Samuele68/airsense/calibration data/round2/data/20180110_112239.jpg

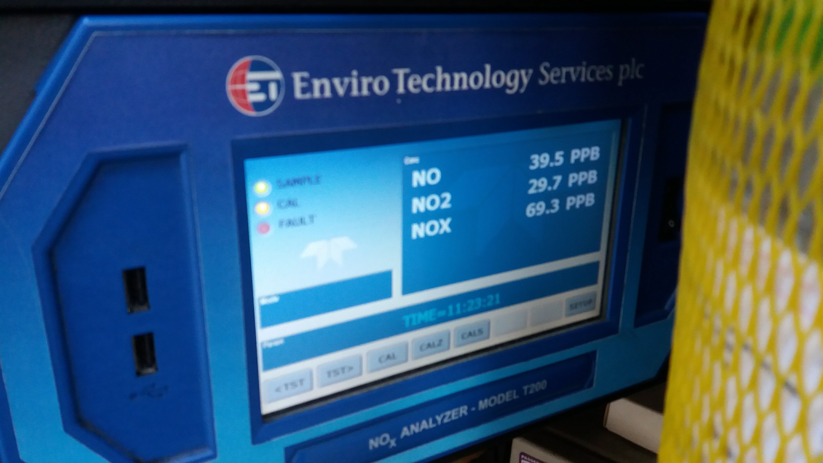
calibration data/round2/data/20180110_112239.jpg
