Samuele68/airsense/calibration data/round2/data/20180118_114009.jpg

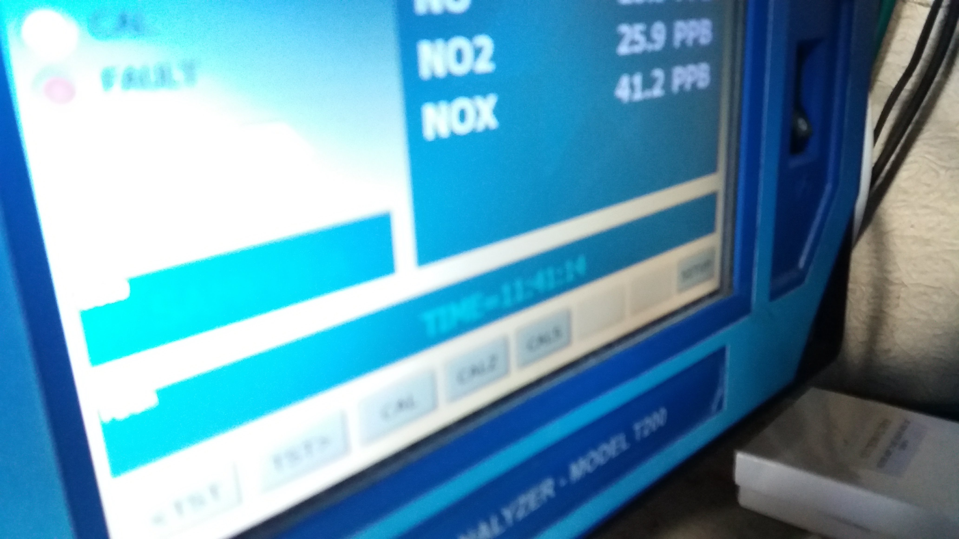
calibration data/round2/data/20180118_114009.jpg
