Samuele68/airsense/README.md

# airsense
a DIY affordable air quality sensor
