Samuele68/airsense/calibration data/round2/data/README.md

Files:

airsense.csv: data collected by the DIY sensor
reference.csv: data collected by official monitor

- Started: 10/01/2018
11:22:39 at mobile phone
11:23:21 at reference
0 at sensor

- Stopped: 18/01/2018
11:40:09 at mobile phone
11:41:14 at reference
691672514 at sensor
