Samuele68/airsense/calibration data/round2/analysis/README.md

#Aanalysis of the calibration data, round 2

This code is written in JavaScript and runs with nodejs.

    npm install

To install dependencies. Then

    node analysis.js

To see the results.
