Samuele68/airsense/calibration data/round1/data/AIRSENSE.CSV

timestamp humidity temperature rawNO2_Mics rawNO2_SPEC rawNO2_Alpha1 rawNO2_Alpha2 rawmq2 dustratio
38643 55 25 931 274 17 6 64 0.00
98813 50 20 898 286 32 29 48 2.64
158978 -1 -1 872 288 36 36 45 69.68
219210 -1 -1 847 323 40 37 43 44.17
279454 -1 -1 810 303 45 40 46 12.78
339641 -1 -1 795 251 46 41 42 14.88
400094 -1 -1 770 307 48 41 45 12.40
460236 -1 -1 755 295 43 41 41 31.61
520308 0 0 744 291 48 41 41 38.89
580462 -1 -1 726 279 47 43 42 46.10
640559 -1 -1 725 286 49 43 42 55.27
700670 -1 -1 700 286 49 42 43 57.77
760838 -1 -1 688 275 49 40 41 56.56
820937 -1 -1 677 287 45 43 42 53.26
880989 47 24 670 281 51 44 39 53.76
941247 -1 -1 664 287 48 44 42 52.18
1001400 65 12 651 283 48 44 42 52.80
1061526 65 18 641 289 51 44 41 54.16
1121681 50 18 626 292 48 43 42 44.86
1181840 65 18 621 293 48 44 40 58.12
1241952 57 12 608 286 49 44 42 57.38
1302078 70 17 604 284 47 44 41 57.48
1362330 65 17 596 291 47 44 41 28.29
1422425 65 17 593 279 49 45 41 37.10
1482683 64 17 586 292 47 44 42 0.87
1542857 60 17 582 291 48 45 42 0.72
1602985 58 17 571 284 49 44 41 0.26
1663688 58 17 560 292 48 45 41 0.08
1724136 61 17 549 284 48 45 41 0.69
1784774 60 17 538 284 49 45 41 0.37
1844978 59 17 536 292 48 45 42 0.21
1905159 60 17 528 285 48 45 41 0.39
1965687 56 17 511 285 49 45 41 0.11
2025853 59 17 504 292 48 45 41 0.19
2086025 59 17 492 283 49 45 41 0.10
2146323 57 17 486 290 48 45 41 0.71
2206803 55 17 480 285 49 45 41 0.00
2267282 59 17 484 285 48 45 40 0.00
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
194354348 82 14 52 273 53 46 43 0.17
194414638 78 19 73 258 48 47 43 0.00
194475024 81 16 50 310 48 45 43 0.04
194535638 81 15 70 303 48 49 43 0.04
194596122 81 16 55 281 48 46 44 0.03
194656822 82 14 65 318 48 45 44 0.39
194717082 82 15 58 263 48 45 43 0.00
194777345 82 15 88 317 50 46 43 0.04
194837825 83 17 76 311 48 45 42 0.00
194898305 82 13 58 305 54 46 43 0.00
194958654 82 16 62 293 49 48 43 0.19
195019308 83 14 64 322 51 46 44 0.20
195079540 83 17 85 301 50 47 43 0.01
195139668 82 16 66 279 51 46 45 0.03
195200140 83 18 66 276 49 47 44 0.13
195260314 78 19 88 279 51 47 43 0.06
195320958 78 19 43 279 48 46 42 0.19
195381368 77 21 52 291 50 47 43 1.15
195441932 81 17 92 298 48 49 43 0.44
195502137 79 17 128 283 52 46 43 0.01
195562339 80 17 99 280 52 46 44 0.39
195622715 79 17 131 313 52 46 43 0.50
195683148 82 17 160 282 49 46 43 0.04
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
