Samuele68/airsense/calibration data/round1/data/reference.csv

TimeStamp | NO2CNC1-AVG(PPB) | NOXCNC1-AVG(PPB) | NOCNC1-AVG(PPB)
05/18/2017 10:41:02 | 0.0 | 33.4 | 33.4
05/18/2017 10:42:01 | 16.8 | 35.3 | 18.4
05/18/2017 10:43:01 | 18.6 | 27.6 | 8.9
05/18/2017 10:44:01 | 17.0 | 26.2 | 9.2
05/18/2017 10:45:01 | 29.5 | 51.6 | 22.1
05/18/2017 10:46:01 | 12.5 | 28.4 | 15.8
05/18/2017 10:47:01 | 24.7 | 66.7 | 42.0
05/18/2017 10:48:01 | 17.7 | 50.4 | 32.7
05/18/2017 10:49:01 | 19.7 | 39.5 | 19.7
05/18/2017 10:50:01 | 12.0 | 66.1 | 54.1
05/18/2017 10:51:01 | 10.8 | 23.1 | 12.3
05/18/2017 10:52:01 | 9.1 | 19.4 | 10.3
05/18/2017 10:53:01 | 9.5 | 22.7 | 13.2
05/18/2017 10:54:01 | 57.7 | 124.5 | 66.8
05/18/2017 10:55:01 | 22.6 | 71.1 | 48.5
05/18/2017 10:56:01 | 11.9 | 25.8 | 13.9
05/18/2017 10:57:01 | 25.2 | 85.1 | 59.9
05/18/2017 10:58:01 | 19.5 | 46.3 | 26.8
05/18/2017 10:59:01 | 3.8 | 12.7 | 8.8
05/18/2017 11:00:01 | 18.4 | 30.1 | 11.7
05/18/2017 11:01:01 | 17.2 | 29.6 | 12.4
05/18/2017 11:02:01 | 18.5 | 65.9 | 47.4
05/18/2017 11:03:01 | 18.5 | 26.8 | 8.3
05/18/2017 11:04:01 | 25.0 | 67.6 | 42.6
05/18/2017 11:05:01 | 110.0 | 197.0 | 87.0
05/18/2017 11:06:01 | 9.9 | 16.5 | 6.6
05/18/2017 11:07:01 | 9.1 | 19.3 | 10.2
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
