Samuele68/airsense/calibration data/round2/data/AIRSENSE.CSV

timestamp | temperature | humidity | pressure | custom_MICS | ratio_NH3 | ratio_CO | ratio_NO2 | nh3 | co | no2 | c3h8 | c4h10 | ch4 | h2 | c2h5oh | alpha1 | alpha2 | alphadiff | specdiff
7379 | 10 | 75 | 99904.00 | 938 | 1.0000 | 1.0000 | 1.0000 | -1.0000 | -1.0000 | -1.0000 | -1.0000 | -1.0000 | -1.0000 | -1.0000 | -1.0000 | 3475685 | 478187 | 617219 | -143510
67384 | 10 | 77 | 99908.00 | 903 | 1.0000 | 1.0000 | 1.0000 | -1.0000 | -1.0000 | -1.0000 | -1.0000 | -1.0000 | -1.0000 | -1.0000 | -1.0000 | 340904 | 631479 | 420449 | 208140
127384 | 10 | 77 | 99918.00 | 885 | 1.0000 | 1.0000 | 1.0000 | -1.0000 | -1.0000 | -1.0000 | -1.0000 | -1.0000 | -1.0000 | -1.0000 | -1.0000 | 191822 | 627501 | 402771 | 224223
187394 | 9 | 77 | 99914.00 | 871 | 1.0000 | 1.0000 | 1.0000 | -1.0000 | -1.0000 | -1.0000 | -1.0000 | -1.0000 | -1.0000 | -1.0000 | -1.0000 | 236047 | 626122 | 396668 | 224490
247397 | 10 | 77 | 99913.00 | 861 | 1.0000 | 1.0000 | 1.0000 | -1.0000 | -1.0000 | -1.0000 | -1.0000 | -1.0000 | -1.0000 | -1.0000 | -1.0000 | 1361908 | 620748 | 394507 | 224027
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
