Samuele68/airsense/calibration data/round2/data/reference.csv

Date | Time | NO2CNC1 | NOXCNC1 | NOCNC1
2018/01/12 | 00:44 | 25.3 | 66.8 | 41.5
2018/01/12 | 00:45 | 0.0 | 0.0 | 0.0
2018/01/12 | 00:46 | 0.0 | 0.0 | 0.0
2018/01/12 | 00:47 | 0.0 | 0.0 | 0.0
2018/01/12 | 00:48 | 0.0 | 0.0 | 0.0
2018/01/12 | 00:49 | 0.0 | 0.0 | 0.0
2018/01/12 | 00:50 | 0.0 | 0.0 | 0.0
2018/01/12 | 00:51 | 0.0 | 0.0 | 0.0
2018/01/12 | 00:52 | 0.0 | 0.0 | 0.0
2018/01/12 | 00:53 | 0.0 | 0.0 | 0.0
2018/01/12 | 00:54 | 0.0 | 0.0 | 0.0
2018/01/12 | 00:55 | 0.0 | 0.0 | 0.0
2018/01/12 | 00:56 | 0.0 | 0.0 | 0.0
2018/01/12 | 00:57 | 0.0 | 0.0 | 0.0
2018/01/12 | 00:58 | 0.0 | 0.0 | 0.0
2018/01/12 | 00:59 | 0.0 | 0.0 | 0.0
2018/01/12 | 01:00 | 0.0 | 0.0 | 0.0
2018/01/12 | 01:01 | 0.0 | 0.0 | 0.0
2018/01/12 | 01:02 | 0.0 | 0.0 | 0.0
2018/01/12 | 01:03 | 0.0 | 0.0 | 0.0
2018/01/12 | 01:04 | 0.0 | 0.0 | 0.0
2018/01/12 | 01:05 | 0.0 | 0.0 | 0.0
2018/01/12 | 01:06 | 0.0 | 0.0 | 0.0
2018/01/12 | 01:07 | 0.0 | 0.0 | 0.0
2018/01/12 | 01:08 | 0.0 | 0.0 | 0.0
2018/01/12 | 01:09 | 0.0 | 0.0 | 0.0
2018/01/12 | 01:10 | 0.0 | 0.0 | 0.0
2018/01/12 | 01:11 | 0.0 | 0.0 | 0.0
2018/01/12 | 01:12 | 0.0 | 0.0 | 0.0
2018/01/12 | 01:13 | 0.0 | 0.0 | 0.0
2018/01/12 | 01:14 | 0.0 | 0.0 | 0.0
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
