Samuele68/airsense/calibration data/round3/data/Log-20190118-102419.log.csv

Date | Time | NO2CNC1 | NOXCNC1 | NOCNC1
2019/1/4 | 13:29 | 23.6 | 38.9 | 15.3
2019/1/4 | 13:30 | 12.8 | 29.2 | 16.4
2019/1/4 | 13:31 | 17.8 | 39.8 | 22.0
2019/1/4 | 13:32 | 12.9 | 30.9 | 18.0
2019/1/4 | 13:33 | 13.7 | 34.6 | 20.8
2019/1/4 | 13:34 | 14.6 | 36.3 | 21.7
2019/1/4 | 13:35 | 44.0 | 97.2 | 53.2
2019/1/4 | 13:36 | 6.9 | 14.6 | 7.6
2019/1/4 | 13:37 | 51.0 | 101.4 | 50.4
2019/1/4 | 13:38 | 12.2 | 45.6 | 33.4
2019/1/4 | 13:39 | 48.3 | 117.7 | 69.4
2019/1/4 | 13:40 | 38.7 | 88.5 | 49.8
2019/1/4 | 13:41 | 18.5 | 32.8 | 14.3
2019/1/4 | 13:42 | 10.5 | 20.6 | 10.1
2019/1/4 | 13:43 | 10.6 | 21.2 | 10.7
2019/1/4 | 13:44 | 24.3 | 44.9 | 20.7
2019/1/4 | 13:45 | 23.3 | 59.2 | 35.9
2019/1/4 | 13:46 | 33.7 | 100.0 | 66.3
2019/1/4 | 13:47 | 9.9 | 46.4 | 36.5
2019/1/4 | 13:48 | 19.5 | 38.8 | 19.3
2019/1/4 | 13:49 | 19.8 | 35.0 | 15.2
2019/1/4 | 13:50 | 19.0 | 33.4 | 14.5
2019/1/4 | 13:51 | 2.3 | 41.3 | 39.1
2019/1/4 | 13:52 | 43.0 | 77.9 | 34.9
2019/1/4 | 13:53 | 4.4 | 6.3 | 1.9
2019/1/4 | 13:54 | 30.4 | 151.4 | 121.0
2019/1/4 | 13:55 | 28.5 | 81.4 | 52.9
2019/1/4 | 13:56 | 28.5 | 96.6 | 68.1
2019/1/4 | 13:57 | 23.4 | 123.1 | 99.7
2019/1/4 | 13:58 | 14.0 | 29.7 | 15.7
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
