Samuele68/airsense/calibration data/round3/data/Log-20190122-093909.log.csv

Date | Time | NO2CNC1 | NOXCNC1 | NOCNC1
2019/1/18 | 0:0 | 21.1 | 43.0 | 21.9
2019/1/18 | 0:1 | 14.0 | 34.6 | 20.5
2019/1/18 | 0:2 | 21.7 | 29.9 | 8.2
2019/1/18 | 0:3 | 21.2 | 32.7 | 11.6
2019/1/18 | 0:4 | 21.3 | 36.0 | 14.7
2019/1/18 | 0:5 | 28.0 | 63.4 | 35.4
2019/1/18 | 0:6 | 7.5 | 58.5 | 51.0
2019/1/18 | 0:7 | 27.0 | 94.3 | 67.3
2019/1/18 | 0:8 | 20.4 | 80.3 | 60.0
2019/1/18 | 0:9 | 21.0 | 78.0 | 57.0
2019/1/18 | 0:10 | 21.2 | 76.0 | 54.8
2019/1/18 | 0:11 | 21.7 | 73.5 | 51.8
2019/1/18 | 0:12 | 21.8 | 71.1 | 49.3
2019/1/18 | 0:13 | 22.1 | 68.3 | 46.2
2019/1/18 | 0:14 | 22.4 | 65.5 | 43.1
2019/1/18 | 0:15 | 22.4 | 62.1 | 39.6
2019/1/18 | 0:16 | 20.9 | 98.5 | 77.6
2019/1/18 | 0:17 | 20.4 | 66.4 | 45.9
2019/1/18 | 0:18 | 21.2 | 104.9 | 83.6
2019/1/18 | 0:19 | 24.9 | 61.3 | 36.4
2019/1/18 | 0:20 | 24.5 | 61.1 | 36.6
2019/1/18 | 0:21 | 24.2 | 63.2 | 39.0
2019/1/18 | 0:22 | 24.1 | 64.3 | 40.2
2019/1/18 | 0:23 | 24.1 | 64.0 | 39.9
2019/1/18 | 0:24 | 18.2 | 72.7 | 54.5
2019/1/18 | 0:25 | 24.0 | 56.9 | 32.9
2019/1/18 | 0:26 | 23.4 | 47.9 | 24.5
2019/1/18 | 0:27 | 23.1 | 49.7 | 26.6
2019/1/18 | 0:28 | 23.2 | 51.2 | 28.0
2019/1/18 | 0:29 | 22.3 | 78.8 | 56.6
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
