Samuele68/airsense/calibration data/round3/data/IMG_20190102_134548.jpg

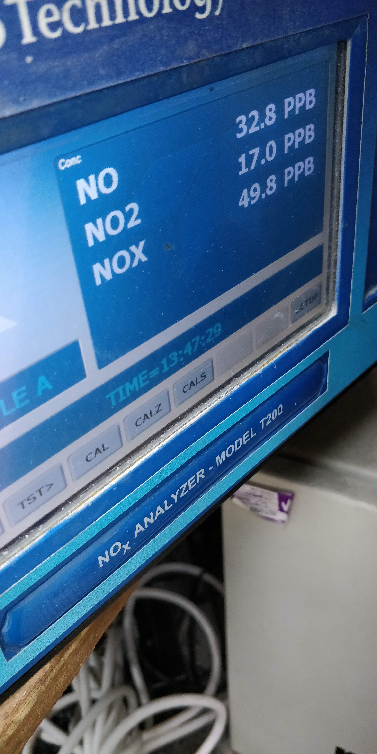
calibration data/round3/data/IMG_20190102_134548.jpg
