Samuele68/airsense/Arduino sketches/testADS1256/testADS1256.ino

#include <Wire.h>
#include <SPI.h>

#define ADS_RST_PIN             4        // ADS1256 reset pin
#define ADS_CS_PIN              5        // ADS1256 chip select
#define ADS_RDY_PIN             6        // ADS1256 data ready

void setup() {
  Serial.begin(9600);

  //start the spi-bus
  SPI.begin();
  initADS();
}

void loop() {
  long alpha0 = readADS(0);
  long alpha1 = readADS(1);
  long alphadiff = readADSDiff(0, 1);
  
  Serial.print(alpha0);
  Serial.print(",");
  Serial.print(alpha1);
  Serial.print(",");
  Serial.print(alphadiff);
  Serial.println();
  
  delay(150);
}
