Samuele68/airsense/(commit log)

2018-06-24 added calibration data, round 1 and round 2
    [AIRSENSE.CSV, reference.csv]
2018-12-15 added support for NTP, not working
    [SIM800.ino, TestSeeduinoGPRS.ino]
2018-12-17 added more control over errors and more data logging
    [Airsense_3.ino, SIM800.ino]
2018-12-23 maybe more stable code in case of no connection
2018-12-23 sending samples more frequently
2019-03-29 adding reference for round 3 calibration
    [reference_2019-01-04_2019-01-17.csv]
2019-04-24 using original excel file for reference
    [reference_2019-01-04_2019-01-17.csv, reference_2019-01-04_2019-01-17.xlsx]
2019-04-24 log files -> csv files
    [Log-20190118-102419.log.csv, Log-20190122-093909.log.csv, Log-20190129-114056.log.csv, Log-20190201-110630.log.csv, Log-20190204-140411.log.csv, Log-20190208-150109.log.csv, Log-20190211-102551.log.csv, Log-20190214-104139.log.csv]
2019-04-26 analysing round 3 with r
    [AIRSENSE.CSV, Log-20190118-102419.log.csv, Log-20190122-093909.log.csv, Log-20190129-114056.log.csv, Log-20190201-110630.log.csv, Log-20190204-140411.log.csv, Log-20190208-150109.log.csv, Log-20190211-102551.log.csv]
2019-04-26 added analysis of round 3
    [reference_2019-01-04_2019-01-17.csv]
